psas/lv3.0-umbilical-ring/README.md

sw-cad-airframe-umbilical-disconnect
====================================

Solid Works CAD files for the umbilical disconnect

See https://github.com/psas/sw-cad-common#psas-solidworks-setup-and-use-procedures for procedures on using github for Solidworks files
