psas/lv3.0-umbilical-ring/LV2 Umbilical Disconnect/ModifiedAssem v4.1J.SLDASM

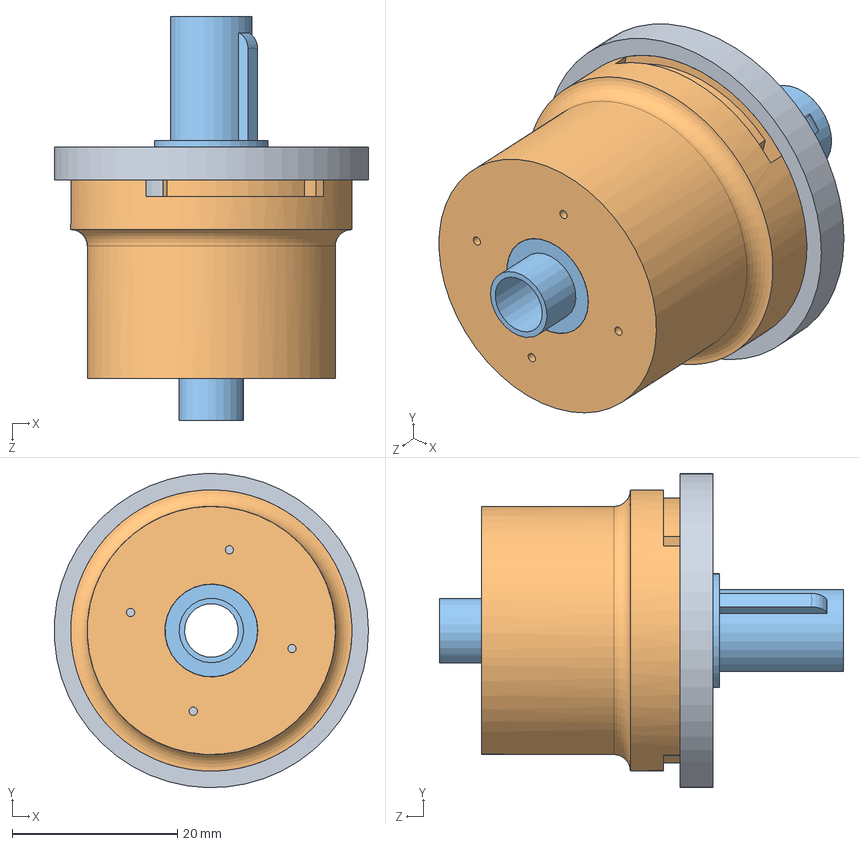
[picture p4: CAD file, 2014-08-06]
LV2 Umbilical Disconnect/ModifiedAssem v4.1J.SLDASM
38.0 x 38.0 x 48.9 mm
Spring end bit v4.1J
Rocket cuff v4.0J
umbilicalchordconnector
