psas/lv3.0-umbilical-ring/LV3 Umbilical Disconnect/CAD/umbilicalPassthrough.SLDASM

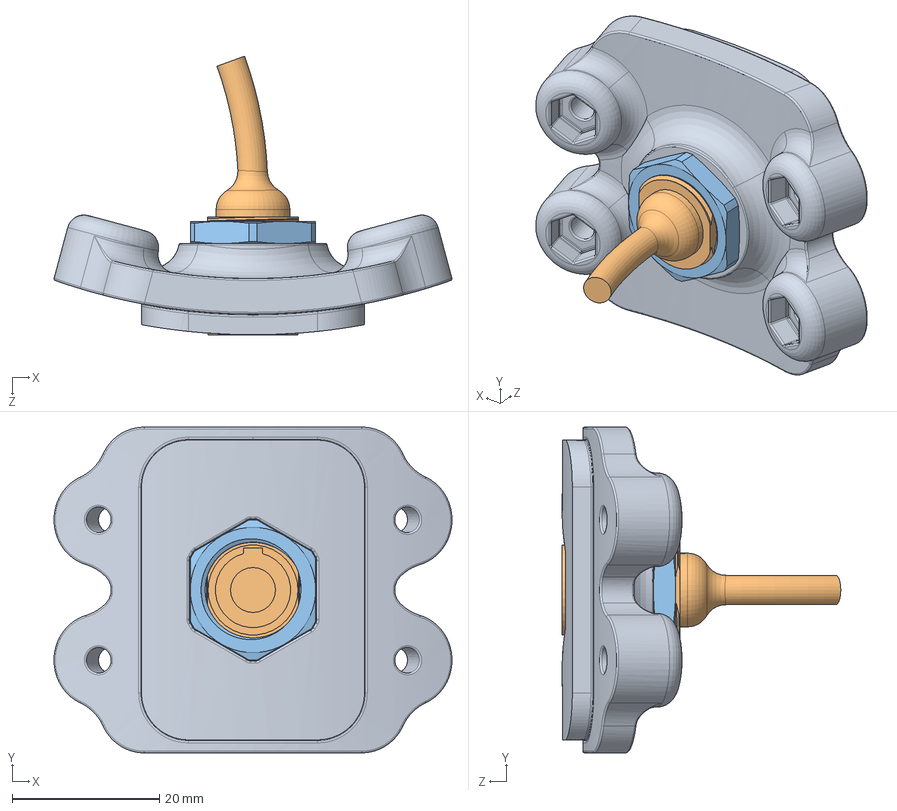
[picture p5: CAD file, 2018-03-19]
LV3 Umbilical Disconnect/CAD/umbilicalPassthrough.SLDASM
54.0 x 44.2 x 37.8 mm
umbilicalPassthrough
ODUmedisnap
M14x1x3nut_medisnap x 2
