psas/lv3.0-umbilical-ring/LV3 Umbilical Disconnect/umbilicalRing.SLDASM

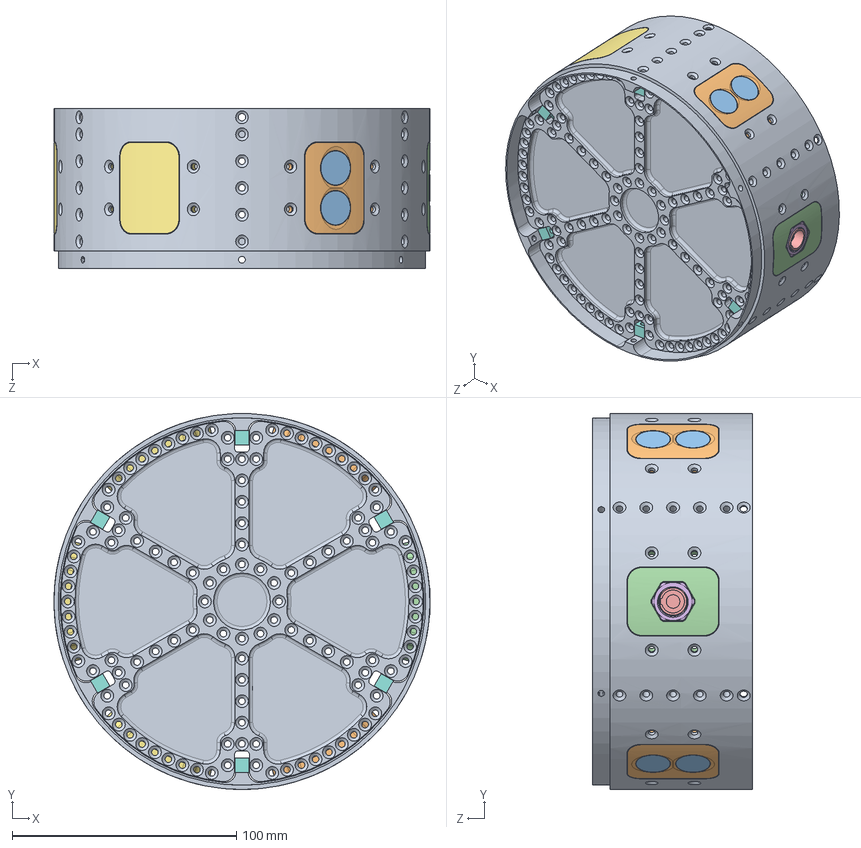
[picture p6: CAD file, 2018-03-01]
LV3 Umbilical Disconnect/umbilicalRing.SLDASM
167.6 x 167.6 x 71.1 mm
360_RunCam_Ring
switchPassthrough x 2
armingSwitch_SWA1_33-4514 x 4
umbilicalPassthrough
ODUmedisnap
M14x1x3nut_medisnap x 2
windowPlug x 3
bulkheadBracket x 12
Camera Bulkhead x 2
