psas/lv3.0-umbilical-ring/LV3 Umbilical Disconnect/CAD/switchPassthrough.SLDASM

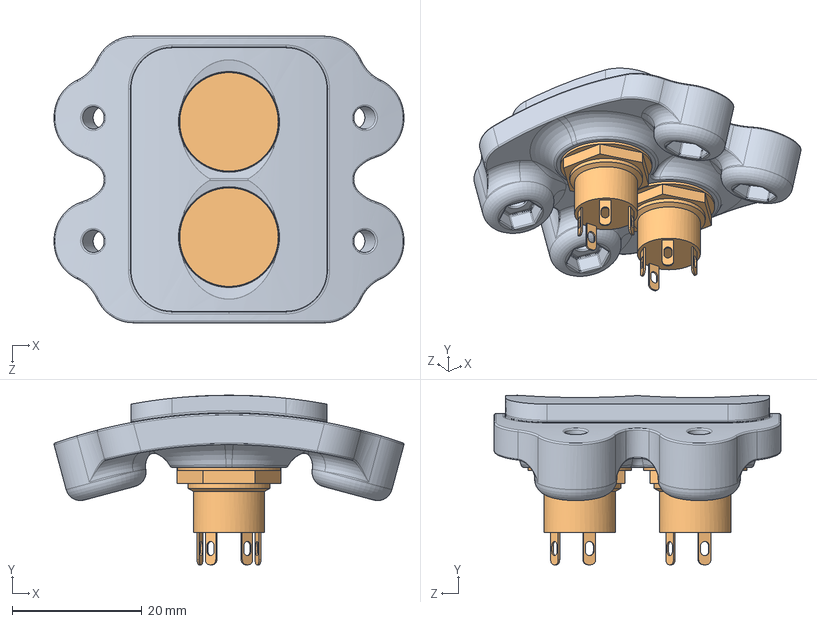
[picture p7: CAD file, 2018-03-01]
LV3 Umbilical Disconnect/CAD/switchPassthrough.SLDASM
54.0 x 26.1 x 44.2 mm
switchPassthrough
armingSwitch_SWA1_33-4514 x 2
