psas/lv3.0-umbilical-ring/LV2 Umbilical Disconnect/modifiedAssem v4.0J.SLDASM

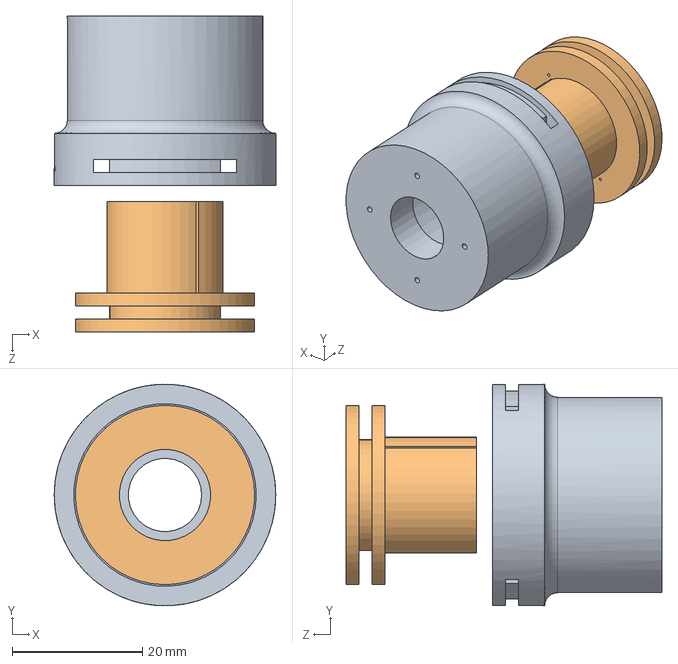
[picture p8: CAD file, 2014-08-06]
LV2 Umbilical Disconnect/modifiedAssem v4.0J.SLDASM
34.0 x 34.0 x 48.5 mm
Rocket cuff v4.0J
Spring end bit v4.0J
