psas/lv3.0-umbilical-ring/LV3 Umbilical Disconnect/passthroughRing_3piece.SLDASM

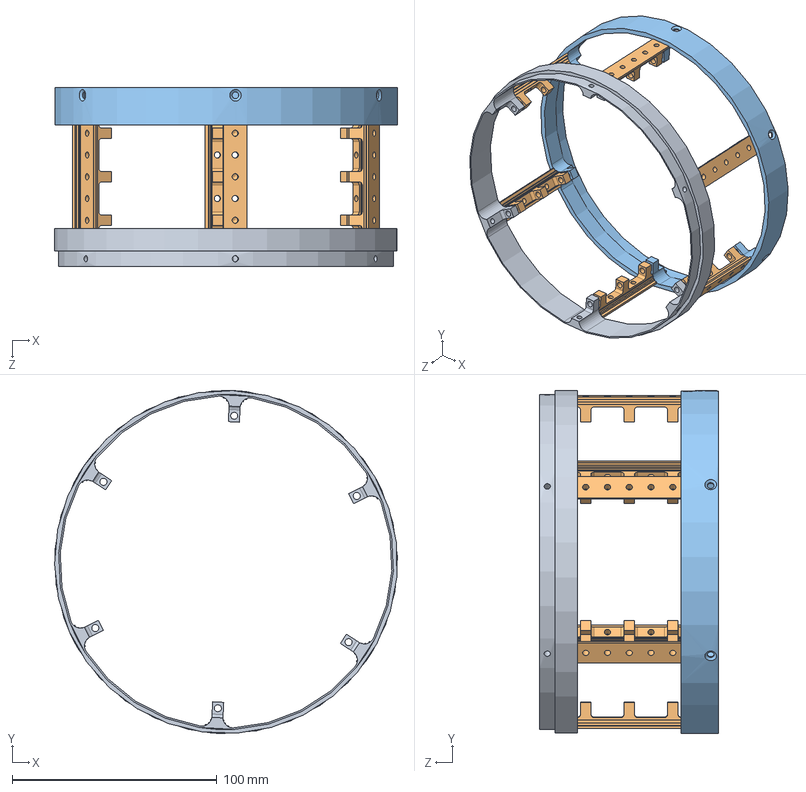
[picture p9: CAD file, 2018-02-28]
LV3 Umbilical Disconnect/passthroughRing_3piece.SLDASM
167.6 x 167.6 x 87.5 mm
maleEnd
pillar_2in_simple x 6
femaleEnd
