psas/lv3.0-umbilical-ring/LV3 Umbilical Disconnect/end_male.SLDASM

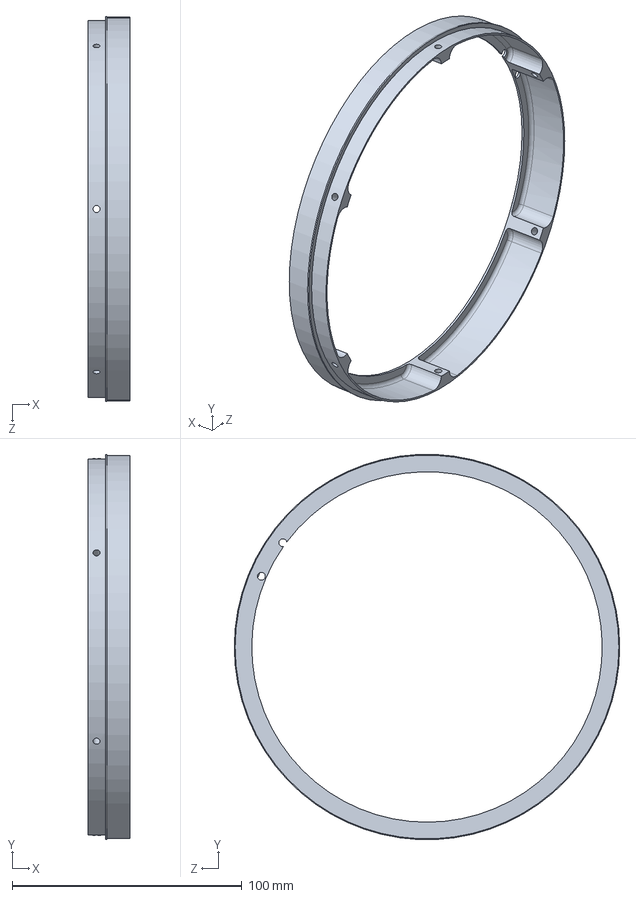
[picture p10: CAD file, 2018-02-28]
LV3 Umbilical Disconnect/end_male.SLDASM
18.5 x 167.5 x 167.6 mm
