psas/lv3.0-umbilical-ring/LV2 Umbilical Disconnect/Rocket cuff v5.0J.SLDPRT

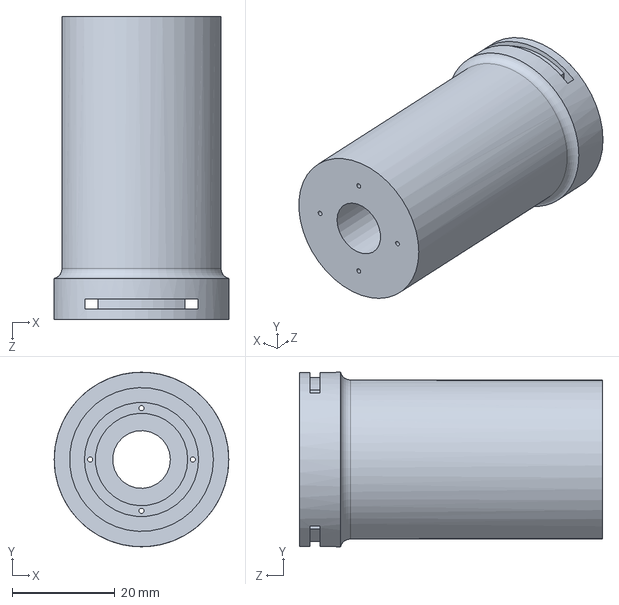
[picture p11: CAD file, 2014-08-06]
LV2 Umbilical Disconnect/Rocket cuff v5.0J.SLDPRT
34.0 x 34.0 x 59.0 mm
