psas/lv3.0-umbilical-ring/LV3 Umbilical Disconnect/pillar_2in.SLDPRT

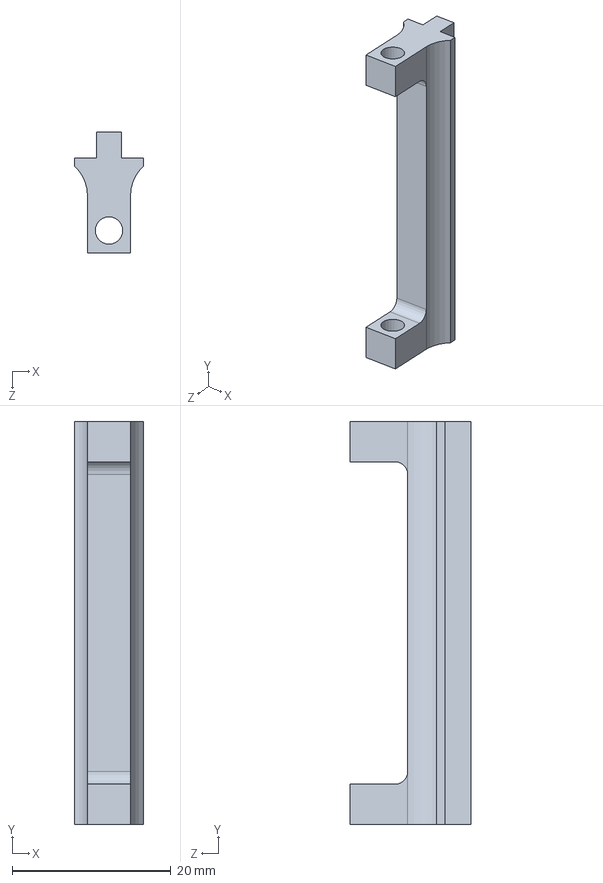
[picture p12: CAD file, 2018-02-28]
LV3 Umbilical Disconnect/pillar_2in.SLDPRT
8.68 x 50.8 x 15.3 mm
