psas/lv3.0-umbilical-ring/LV2 Umbilical Disconnect/Spring end bit4D.SLDPRT

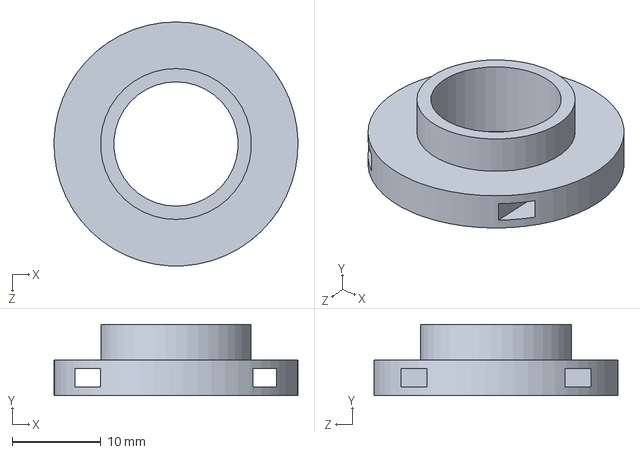
[picture p13: CAD file, 2014-08-06]
LV2 Umbilical Disconnect/Spring end bit4D.SLDPRT
27.5 x 8.00 x 27.5 mm
