psas/lv3.0-umbilical-ring/LV3 Umbilical Disconnect/CAD/armingSwitch_SWA1_33-4514.SLDPRT

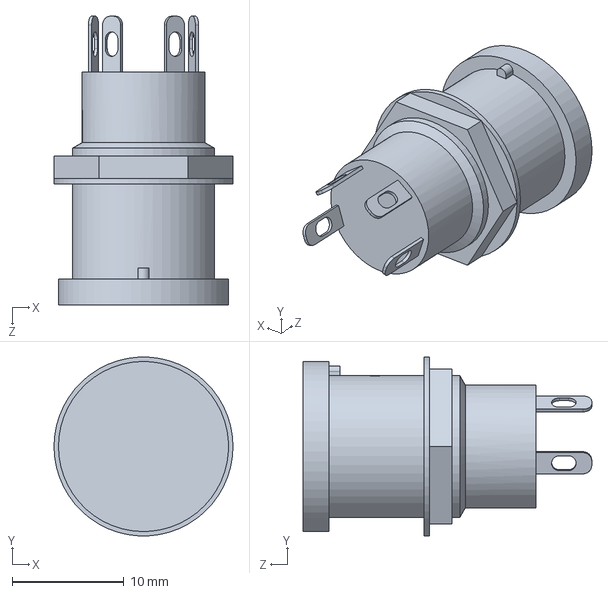
[picture p14: CAD file, 2018-03-01]
LV3 Umbilical Disconnect/CAD/armingSwitch_SWA1_33-4514.SLDPRT
16.0 x 16.0 x 25.8 mm
