psas/lv3.0-umbilical-ring/LV3 Umbilical Disconnect/pillar_2in_simple.SLDPRT

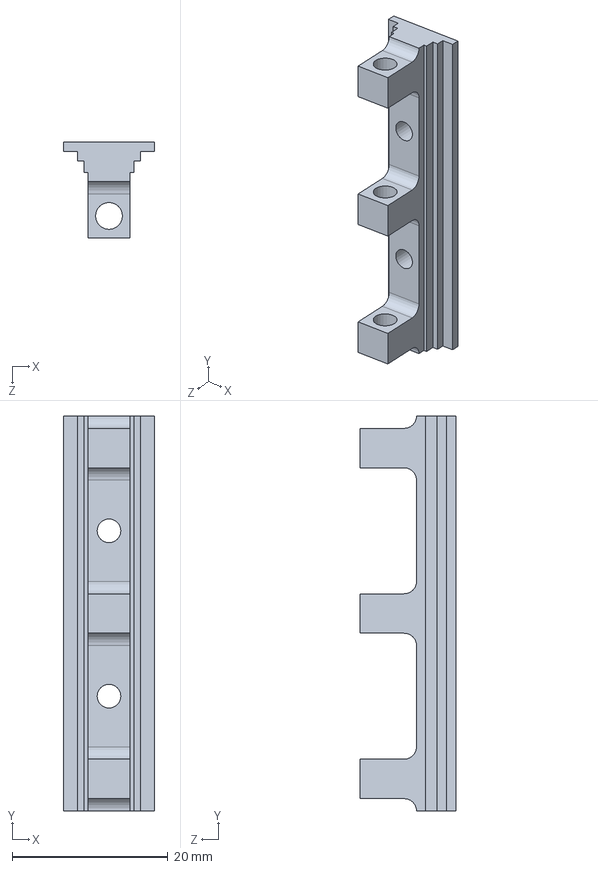
[picture p15: CAD file, 2018-02-28]
LV3 Umbilical Disconnect/pillar_2in_simple.SLDPRT
11.7 x 50.8 x 12.4 mm
