psas/lv3.0-umbilical-ring/LV2 Umbilical Disconnect/Spring end bit v4.1J.SLDPRT

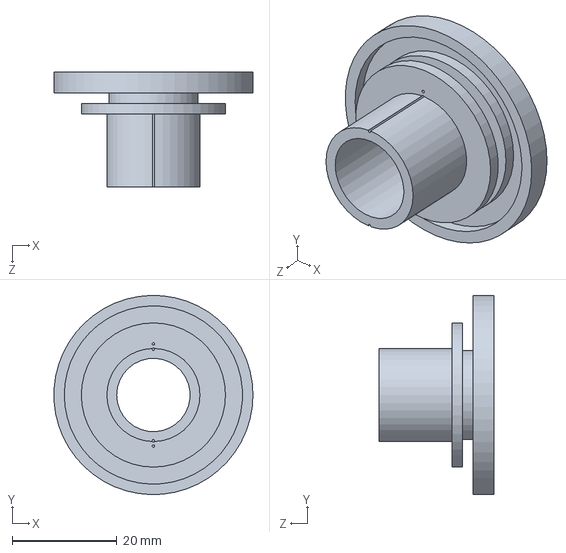
[picture p16: CAD file, 2014-08-06]
LV2 Umbilical Disconnect/Spring end bit v4.1J.SLDPRT
38.0 x 38.0 x 22.0 mm
