psas/lv3.0-umbilical-ring/LV3 Umbilical Disconnect/CAD/ODUmedisnap.SLDPRT

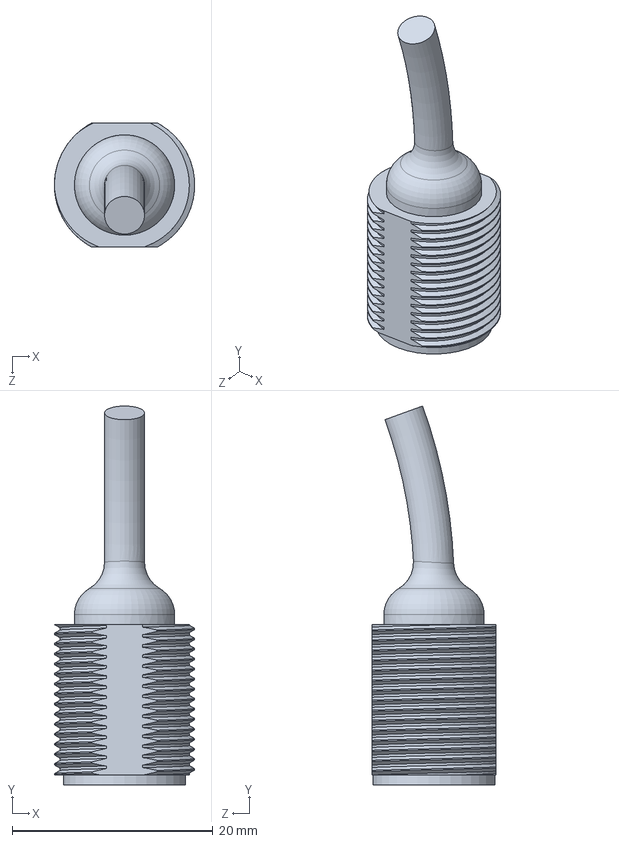
[picture p17: CAD file, 2018-02-28]
LV3 Umbilical Disconnect/CAD/ODUmedisnap.SLDPRT
14.0 x 37.8 x 12.4 mm
