psas/lv3.0-umbilical-ring/LV3 Umbilical Disconnect/maleEnd.SLDPRT

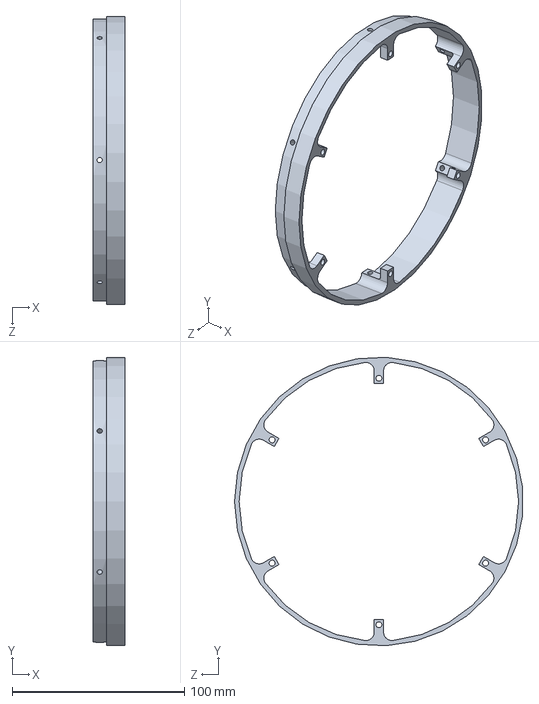
[picture p18: CAD file, 2018-02-28]
LV3 Umbilical Disconnect/maleEnd.SLDPRT
18.5 x 167.4 x 167.2 mm
