psas/lv3.0-umbilical-ring/LV2 Umbilical Disconnect/Spring end bit v4.0J.SLDPRT

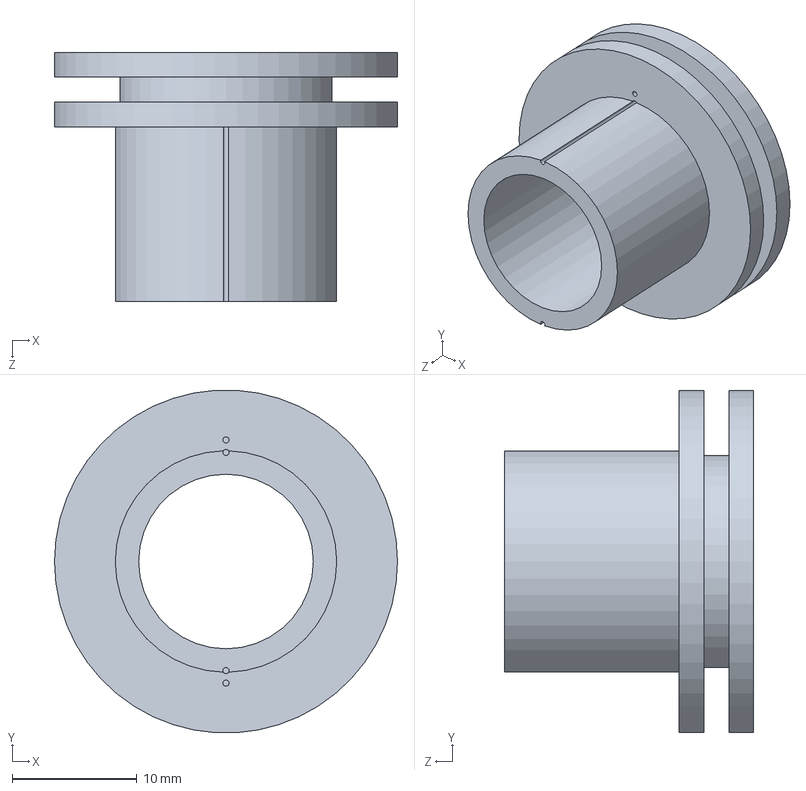
[picture p19: CAD file, 2014-08-06]
LV2 Umbilical Disconnect/Spring end bit v4.0J.SLDPRT
27.5 x 27.4 x 20.0 mm
