psas/lv3.0-umbilical-ring/LV2 Umbilical Disconnect/umbilicalchordconnector.SLDPRT

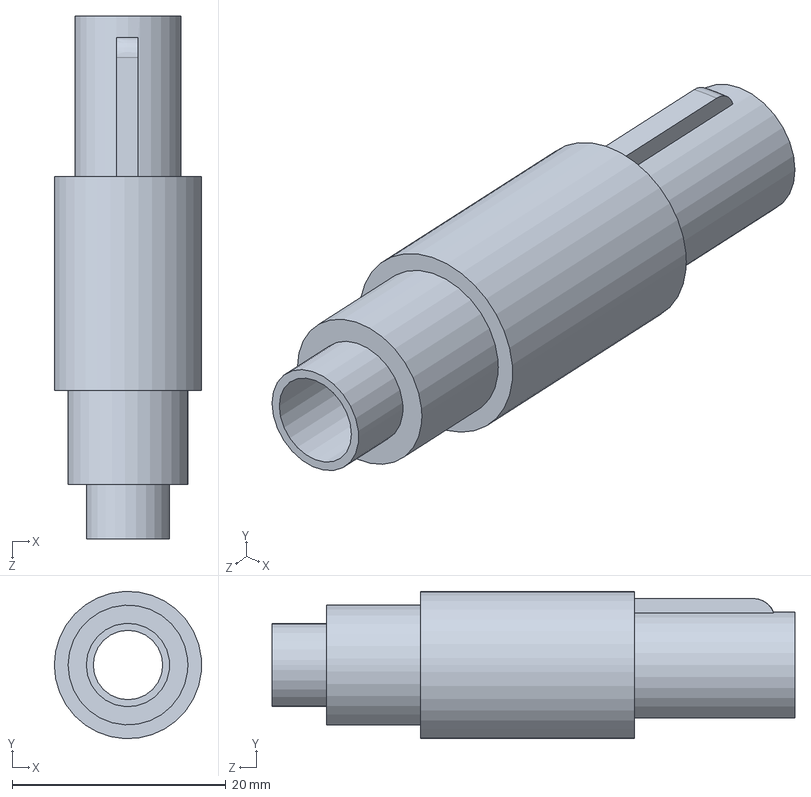
[picture p20: CAD file, 2014-08-06]
LV2 Umbilical Disconnect/umbilicalchordconnector.SLDPRT
13.8 x 13.8 x 48.9 mm
