psas/lv3.0-umbilical-ring/LV2 Umbilical Disconnect/Rocket cuff v5.0D.SLDPRT

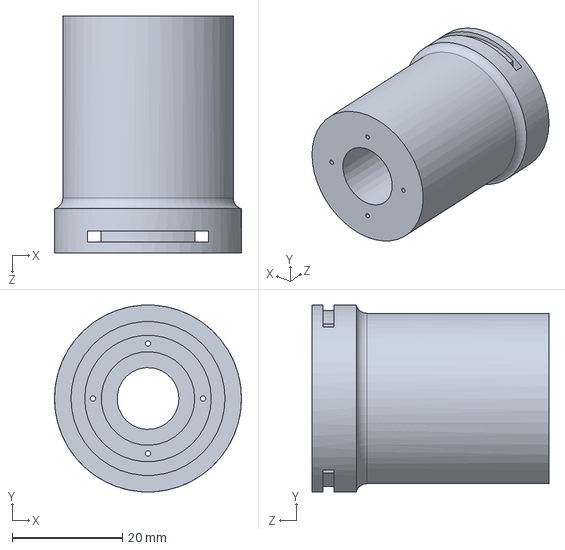
[picture p21: CAD file, 2014-08-06]
LV2 Umbilical Disconnect/Rocket cuff v5.0D.SLDPRT
34.0 x 34.0 x 43.0 mm
