psas/lv3.0-umbilical-ring/(list of files, cad)

Other CAD files:
LV3 Umbilical Disconnect/femaleEnd.SLDPRT
LV2 Umbilical Disconnect/Spring end bit v4.0D.SLDPRT
LV2 Umbilical Disconnect/Rocket cuff v4.0J.SLDPRT
LV3 Umbilical Disconnect/CAD/M14x1x3nut_medisnap.SLDPRT
LV3 Umbilical Disconnect/CAD/switchPassthrough.SLDPRT
LV3 Umbilical Disconnect/CAD/umbilicalPassthrough.SLDPRT
