psas/lv3.0-umbilical-ring/(commit log)

2014-08-06 Initial commit of spring umbilical
    [ModifiedAssem v4.1J.SLDASM, Rocket cuff v1.STL, Rocket cuff v4.0J.SLDPRT, Rocket cuff v5.0D.SLDPRT, Rocket cuff v5.0J.SLDPRT, Rocket cuffv2.SLDPRT, Rocket cuffv3.1D.SLDPRT, Spring end bit v4.0D.SLDPRT]
2014-10-29 Removed old files
    [Rocket cuff v1.STL, Spring end bitv1.STL, umbilicalchordconnectorv1.STL]
2014-10-29 Deleted Old files
    [Rocket cuffv2.SLDPRT, Rocket cuffv3.1D.SLDPRT, Spring end bitv2.SLDPRT, Spring end bitv3.1A.SLDPRT, Spring end bitv3.1D.SLDPRT, Spring end bitv3.SLDPRT]
2014-10-29 Uploaded Analysis Paper of Ejector connector
    Analysis paper that was done for a tech writing class.
2017-06-21 file structures
    [ModifiedAssem v4.1J.SLDASM, Rocket cuff v4.0J.SLDPRT, Rocket cuff v5.0D.SLDPRT, Rocket cuff v5.0J.SLDPRT, Spring end bit v4.0D.SLDPRT, Spring end bit v4.0J.SLDPRT, Spring end bit v4.1J.SLDPRT, Spring end bit4D.SLDPRT]
2018-01-05 initial idea for a passthrough ring
    [end_male.SLDASM, maleEnd.SLDPRT, passthroughRing_3piece.SLDASM, pillar_2in.SLDPRT]
2018-01-06 simple pillar; female end; example assembly
    [femaleEnd.SLDPRT, passthroughRing_3piece.SLDASM, pillar_2in.SLDPRT, pillar_2in_simple.SLDPRT]
2018-01-07 easier machining; mounting holes; low mass rings
    The pillars have a stair-step feature, rather than a chamfer, for easier
    machining.
    Mounting holes were added to the pillars, so we can attach the cowling
    and the internals.
    Superfluous length was removed from the rings to reduce mass.
    [femaleEnd.SLDPRT, passthroughRing_3piece.SLDASM, pillar_2in_simple.SLDPRT]
2018-02-28 got generic passthrough from lv3.0-camera-ring
    [umbilicalPassthrough.SLDPRT]
2018-02-28 modeled medisnap jack
    [ODUmedisnap.SLDPRT]
2018-02-28 forgot the flats...
    [ODUmedisnap.SLDPRT]
2018-02-28 made a socket for the ODU jack
    [umbilicalPassthrough.SLDPRT]
2018-02-28 dogbones, fillets, nitpickery
    [umbilicalPassthrough.SLDPRT]
2018-02-28 finished umbilical passthrough assembly
    [M14x1x3nut_medisnap.SLDPRT, ODUmedisnap.SLDPRT, umbilicalPassthrough.SLDASM, umbilicalPassthrough.SLDPRT]
2018-02-28 Extended the socket to engage the whole connector
    [umbilicalPassthrough.SLDASM, umbilicalPassthrough.SLDPRT]
2018-03-01 added CAD and documentation for arming switches
    [armingSwitch_SWA1_33-4514.stp]
2018-03-01 basic switch socket (no stress relief)
    [armingSwitch_SWA1_33-4514.SLDPRT, armingSwitch_SWA1_33-4514.stp, switchPassthrough.SLDASM, switchPassthrough.SLDPRT]
2018-03-01 prettied up switch passthrough
    [switchPassthrough.SLDASM, switchPassthrough.SLDPRT]
2018-03-01 better method of smoothing flat-to-cylinder
    [switchPassthrough.SLDASM, switchPassthrough.SLDPRT]
2018-03-01 ignored STL files
2018-03-01 created the umbilical assembly
    [umbilicalRing.SLDASM]
2018-03-19 got rid of obnoxious transparent appearance
    [umbilicalPassthrough.SLDASM, umbilicalPassthrough.SLDPRT]
